olinrobotics/FLA/Prop guard assy.pdf

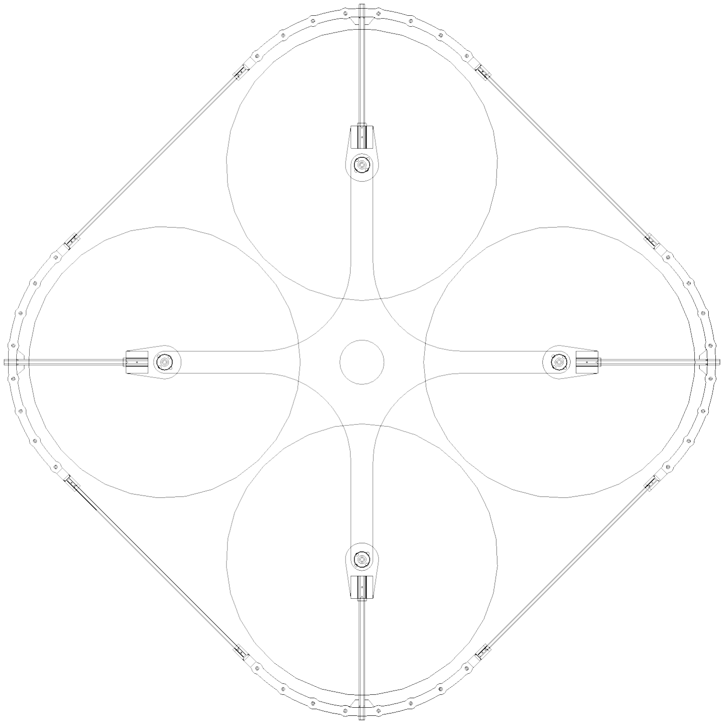
[picture p1: figure]

# Prop

# Guard

# Cage

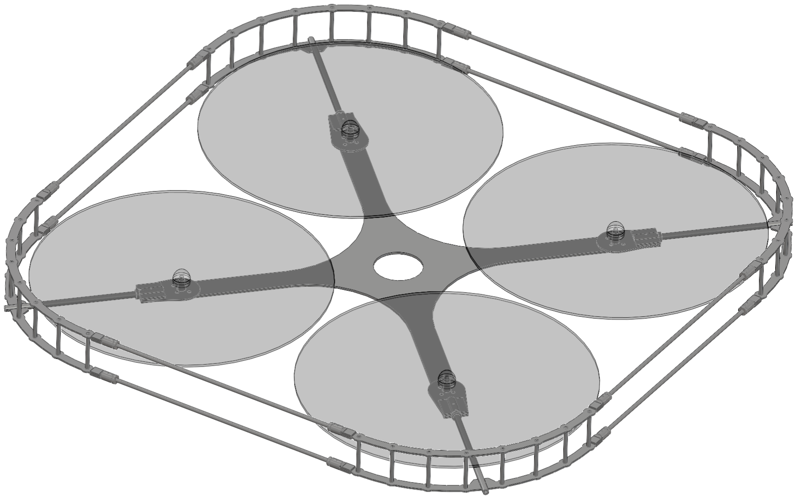
[picture p2: figure]

# Fabrication

Note,

### carbon

### dust

is

### very

### harmful

if

inhaled,

### use

a

### dust

### removal

### system

### when

cu>ng,

sanding,

or

### grinding

### carbon

parts.

### Also

### fumes

### from

CA

### and

### epoxies

### are

harmful,

so

### also

### use

a

### ventilation

### system

### with

### those

adhesives.

### For

### the

epoxy,

### slow

### cure

is

stronger,

5

### minute

### cure

is

okay.

### DP460NS

is

a

### high performance

### epoxy

### that

### would

be

ideal.

### For

### the

CA

### glues

### Bob

### Smith

### brand

### thin

### and

### medium

### viscosity

### glues

### are

good.

### Regular type

is

best,

### but

### foam

### safe

is

okay.

### Also

### the

### foam

### safe

### 'Insta

### Set

### Accelerator'

is

### good for

### kicking

### off

### the

glue,

### particularly

### when

### the

### kevlar

### thread

is

### coated

### with

CA

glue.

### Prepared

by

AV

Inc.

6/2016

### DARPA

### FLA

### Program

1

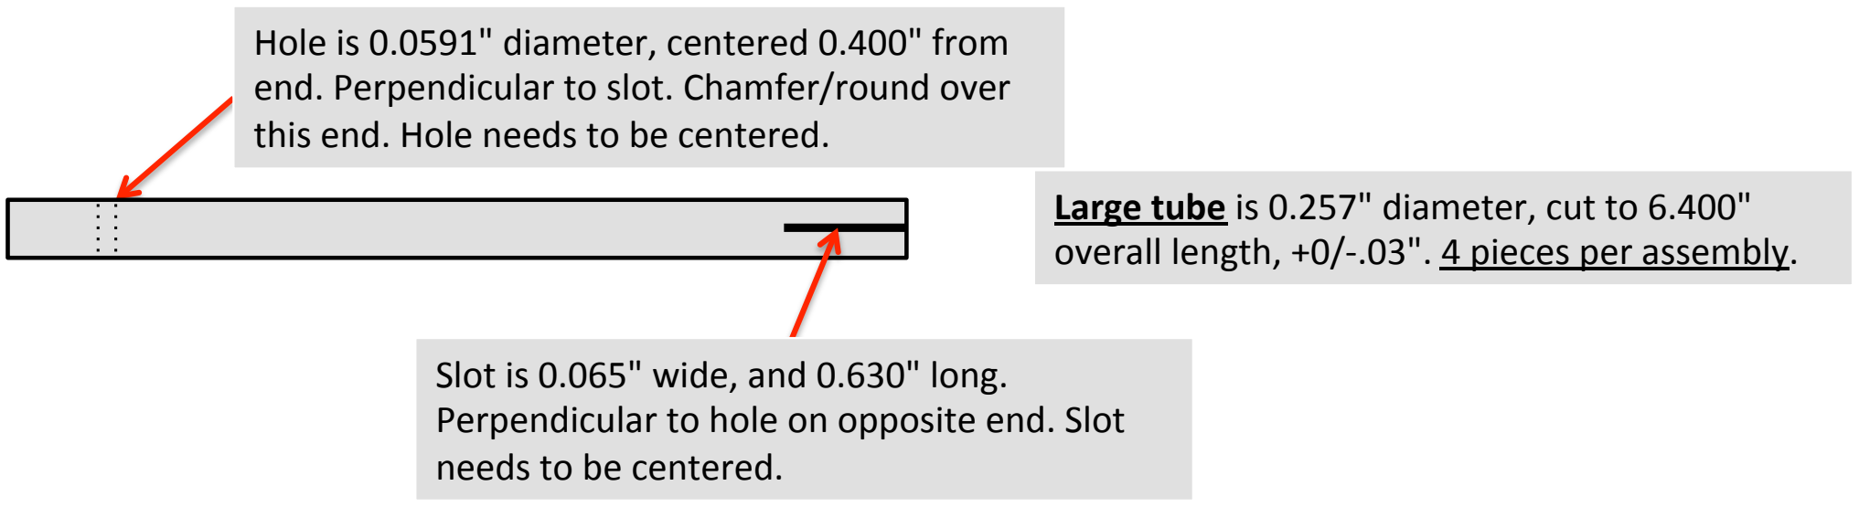
[picture p3: figure]
Large; tube; diameter,; cut; overall; length,; pieces; per; assembly.; Hole; centered; from; end.; Perpendicular; slot.; Chamfer/round; over; this; needs; centered.; Slot; wide,; and; long.; hole; opposite

Small

Short

tube

is

0.155"

diameter,

cut

to
1.930"

overall

length,

+/.02"

32

pieces

per
assembly.

Chamfer/round

over

the

edges.

### Carbon

### tube

### prep

2

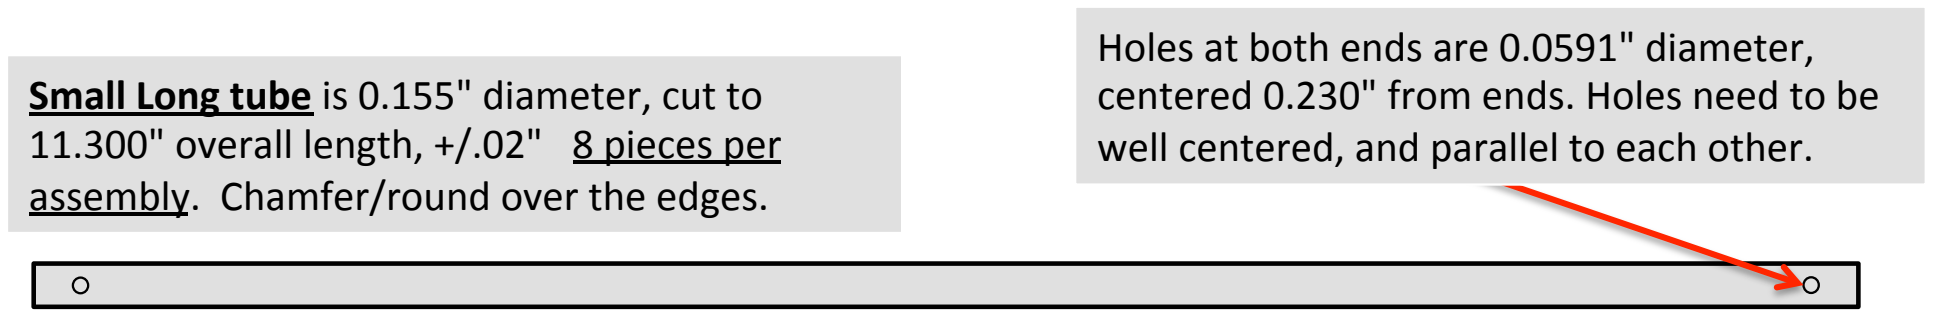
[picture p4: figure]
Small; Long; tube; diameter,; cut; overall; length,; pieces; per; assembly.; Chamfer/round; over; the; edges.; Holes; both; ends; are; centered; from; ends.; need; well; centered,; and; parallel; each; other.

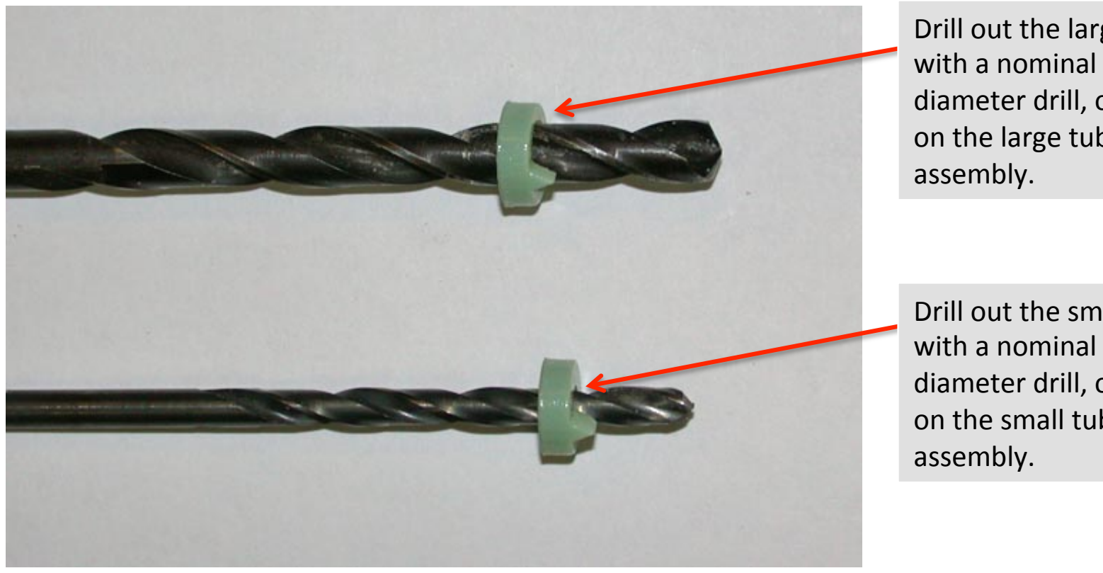
[picture p5: figure]
Drill; out; the; with; nominal diameter; drill,; large assembly.; small assembly.

large

hole

collars
.257"
or

to

fit

snug
tubes.

4

per

small

hole

collars
.156"
or

to

fit

snug
tubes.

16

per

### Collar

### prep

3

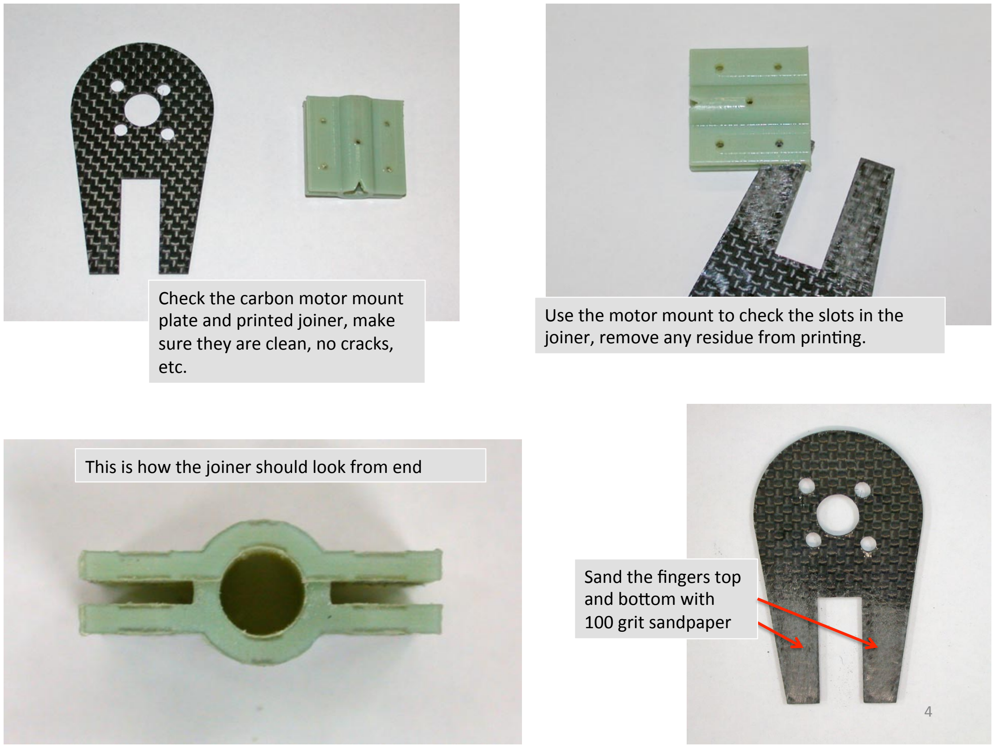
[picture p6: page 4]

Check

the

carbon

motor

mount
plate

and

printed

joiner,

make
sure

they

are

clean,

no

cracks,
etc.

Use

the

motor

mount

to

check

the

slots

in

the
joiner,

remove

any

residue

from

printing.

This

is

how

the

joiner

should

look

from

end

Sand

the

fingers

top
and

bo_om

with
100

grit

sandpaper

4

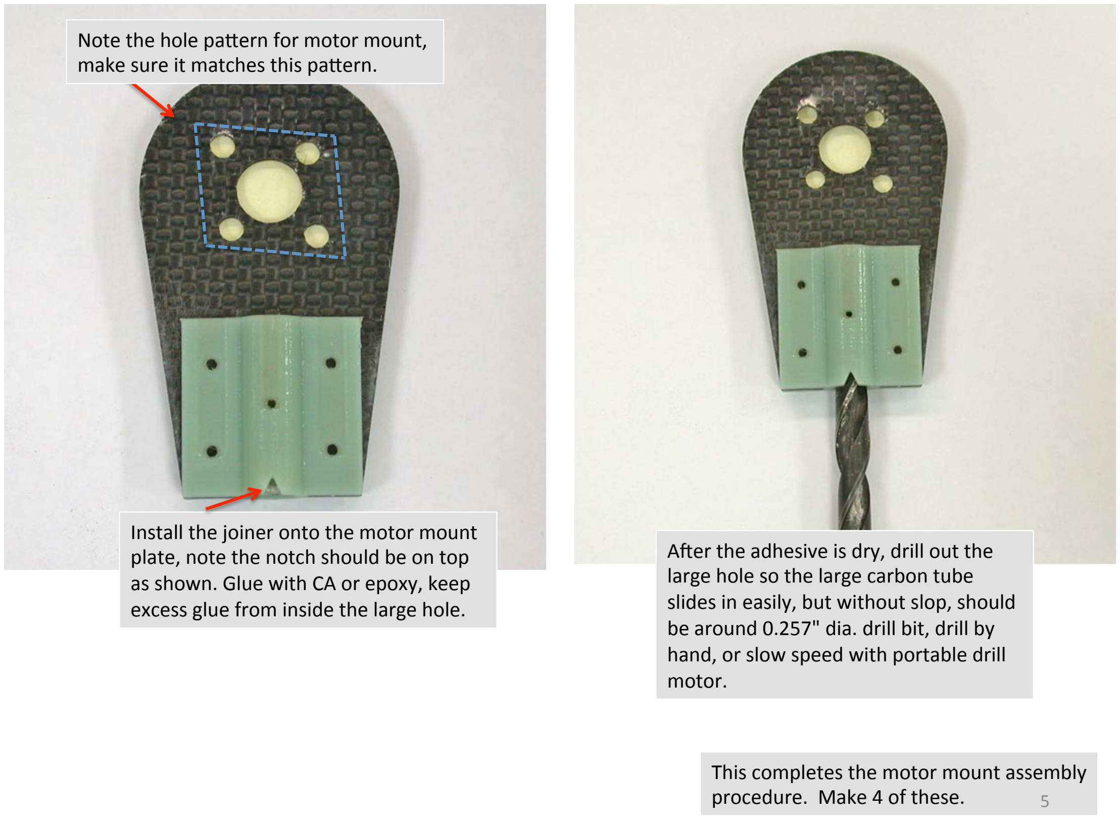
[picture p7: page 5]

Note

the

hole

pa_ern

for

motor

mount,
make

sure

it

matches

this

pa_ern.

Install

the

joiner

onto

the

motor

mount
plate,

note

the

notch

should

be

on

top
as

shown.

Glue

with

CA

or

epoxy,

keep
excess

glue

from

inside

the

large

hole.

A`er

the

adhesive

is

dry,

drill

out

the
large

hole

so

the

large

carbon

tube
slides

in

easily,

but

without

slop,

should
be

around

0.257"

dia.

drill

bit,

drill

by
hand,

or

slow

speed

with

portable

drill
motor.

This

completes

the

motor

mount

assembly
procedure.

Make

4

of

these.
5

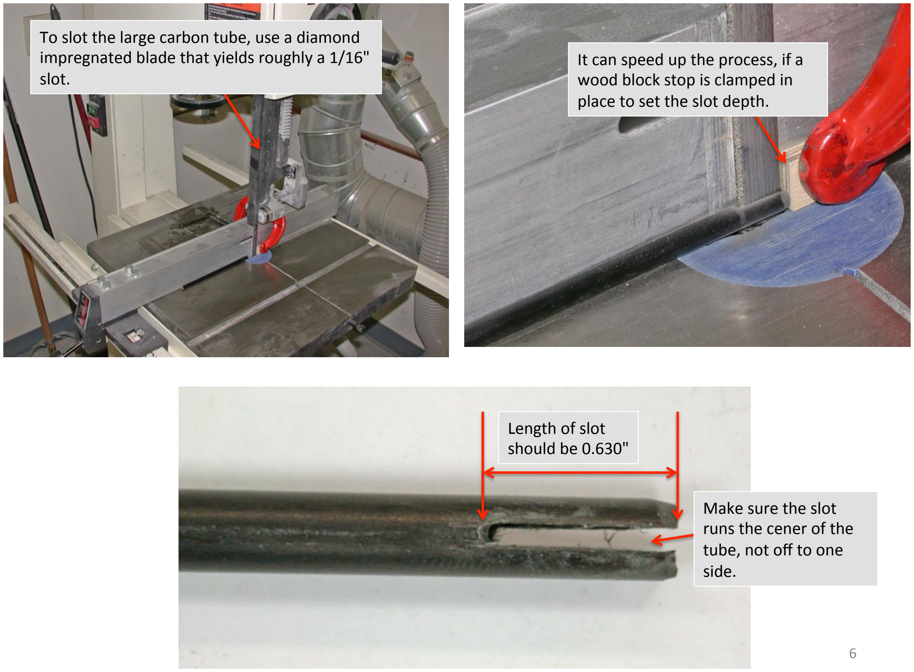
[picture p8: page 6]

To

slot

the

large

carbon

tube,

use

a

diamond
impregnated

blade

that

yields

roughly

a

1/16"
slot.

It

can

speed

up

the

process,

if

a
wood

block

stop

is

clamped

in
place

to

set

the

slot

depth.

Make

sure

the

slot
runs

the

cener

of

the
tube,

not

off

to

one
side.

Length

of

slot
should

be

0.630"

6

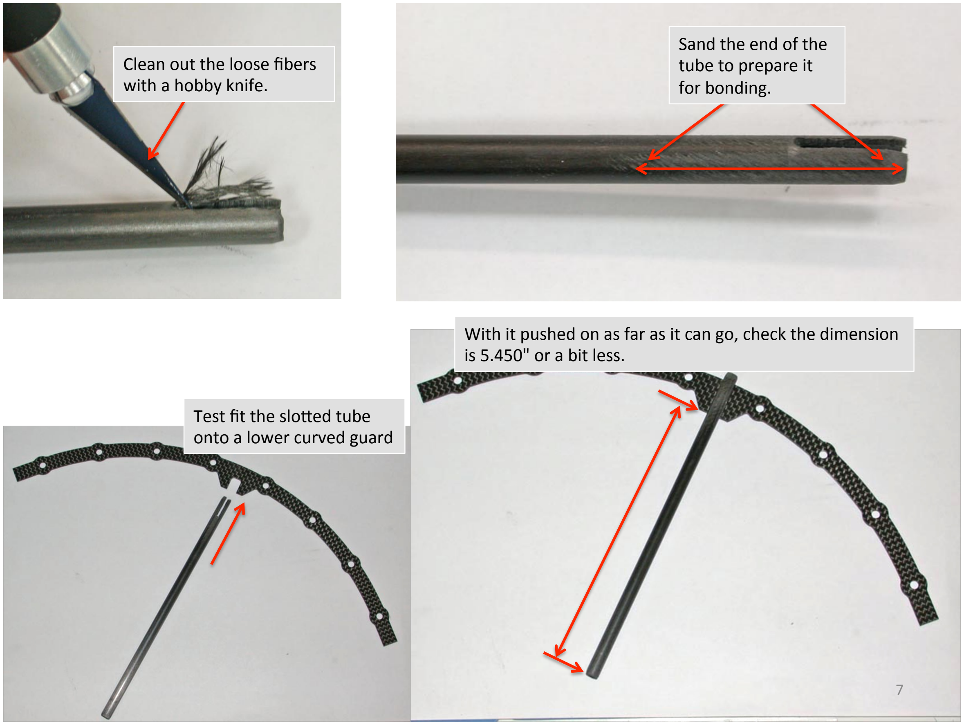
[picture p9: page 7]

Clean

out

the

loose

fibers
with

a

hobby

knife.

Sand

the

end

of

the
tube

to

prepare

it
for

bonding.

Test

fit

the

slo_ed

tube
onto

a

lower

curved

guard

With

it

pushed

on

as

far

as

it

can

go,

check

the

dimension
is

5.450"

or

a

bit

less.

7

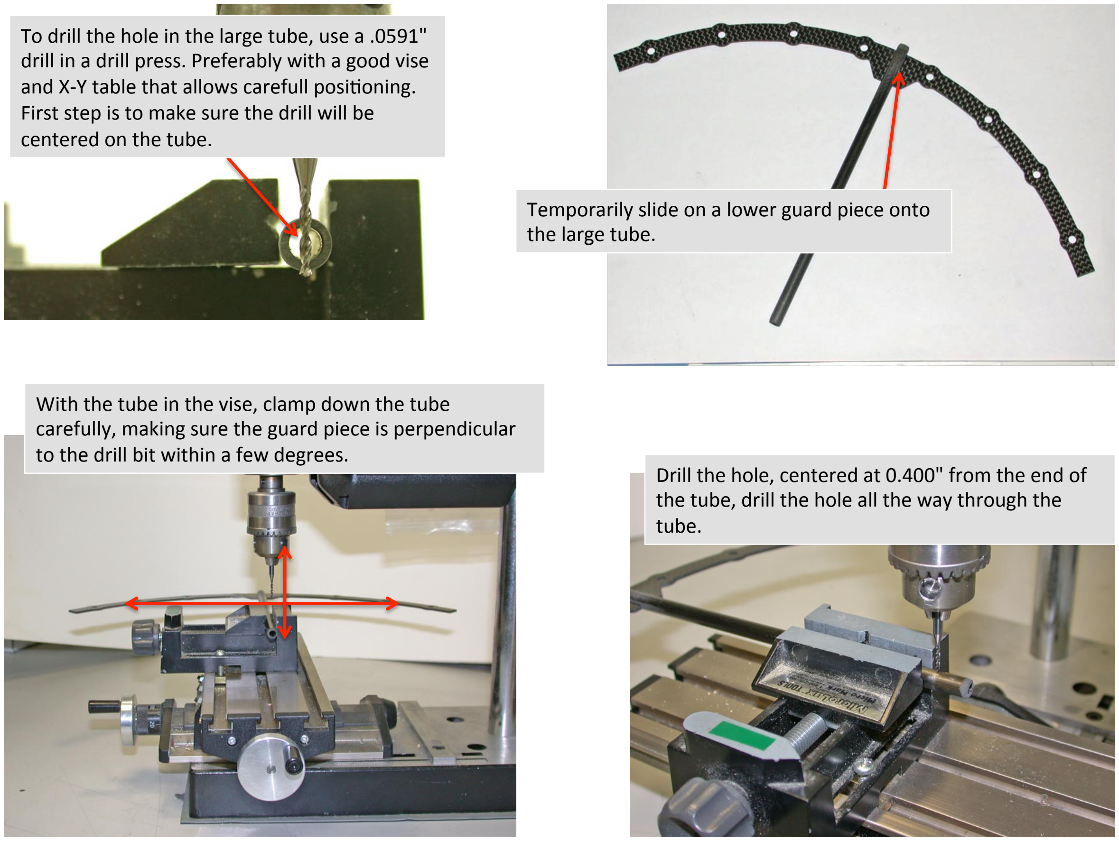
[picture p10: page 8]

To

drill

the

hole

in

the

large

tube,

use

a

.0591"
drill

in

a

drill

press.

Preferably

with

a

good

vise
and

X-‐Y

table

that

allows

carefull

positioning.
First

step

is

to

make

sure

the

drill

will

be
centered

on

the

tube.

Temporarily

slide

on

a

lower

guard

piece

onto
the

large

tube.

With

the

tube

in

the

vise,

clamp

down

the

tube
carefully,

making

sure

the

guard

piece

is

perpendicular
to

the

drill

bit

within

a

few

degrees.
Drill

the

hole,

centered

at

0.400"

from

the

end

of
the

tube,

drill

the

hole

all

the

way

through

the
tube.

8

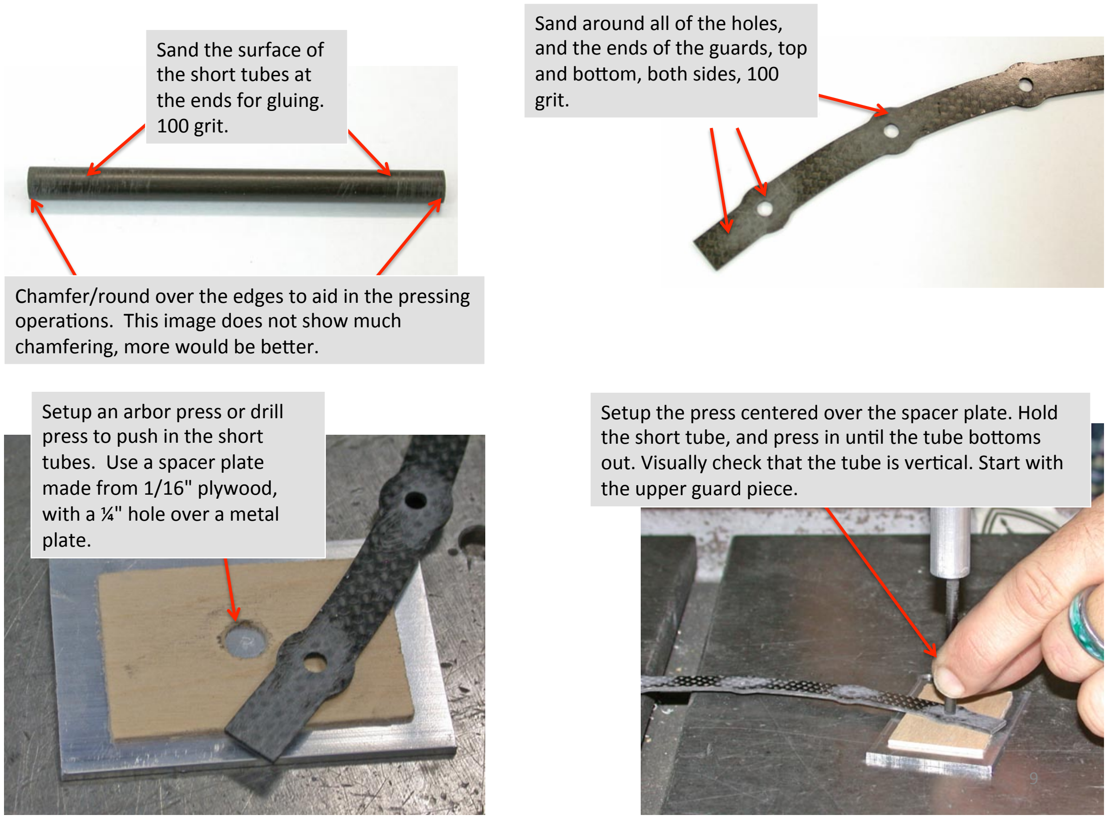
[picture p11: page 9]

Sand

the

surface

of
the

short

tubes

at
the

ends

for

gluing.
100

grit.

Chamfer/round

over

the

edges

to

aid

in

the

pressing
operations.

This

image

does

not

show

much
chamfering,

more

would

be

be_er.

Sand

around

all

of

the

holes,
and

the

ends

of

the

guards,

top
and

bo_om,

both

sides,

100
grit.

Setup

an

arbor

press

or

drill
press

to

push

in

the

short
tubes.

Use

a

spacer

plate
made

from

1/16"

plywood,
with

a

¼"

hole

over

a

metal
plate.

Setup

the

press

centered

over

the

spacer

plate.

Hold
the

short

tube,

and

press

in

until

the

tube

bo_oms
out.

Visually

check

that

the

tube

is

vertical.

Start

with
the

upper

guard

piece.

9

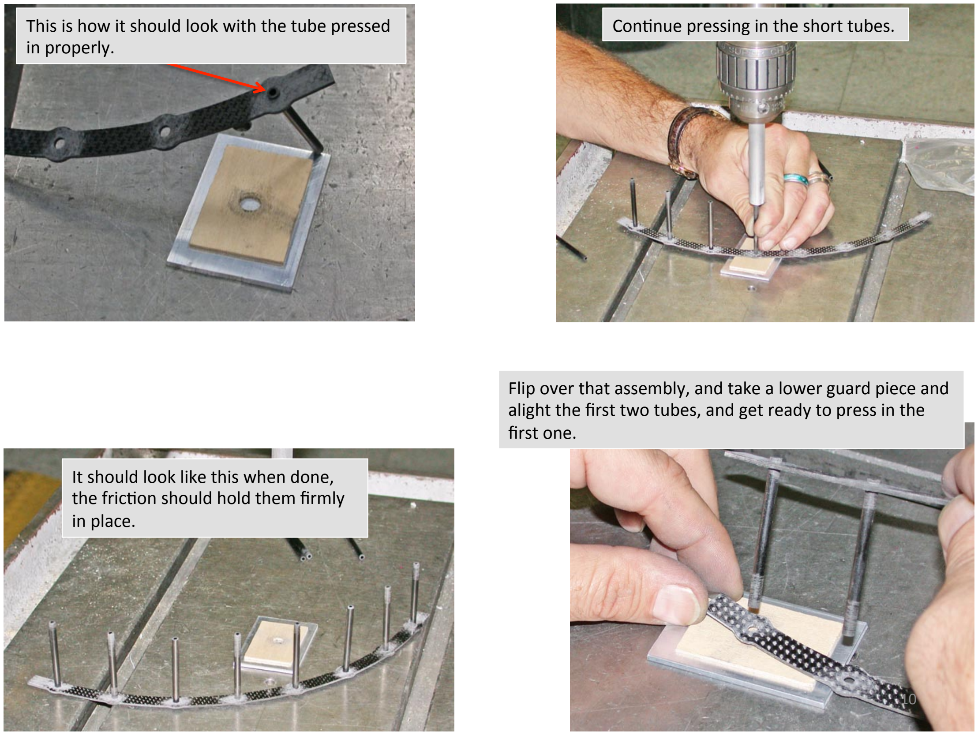
[picture p12: page 10]

This

is

how

it

should

look

with

the

tube

pressed
in

properly.

Continue

pressing

in

the

short

tubes.

It

should

look

like

this

when

done,
the

friction

should

hold

them

firmly
in

place.

Flip

over

that

assembly,

and

take

a

lower

guard

piece

and
alight

the

first

two

tubes,

and

get

ready

to

press

in

the
first

one.

10

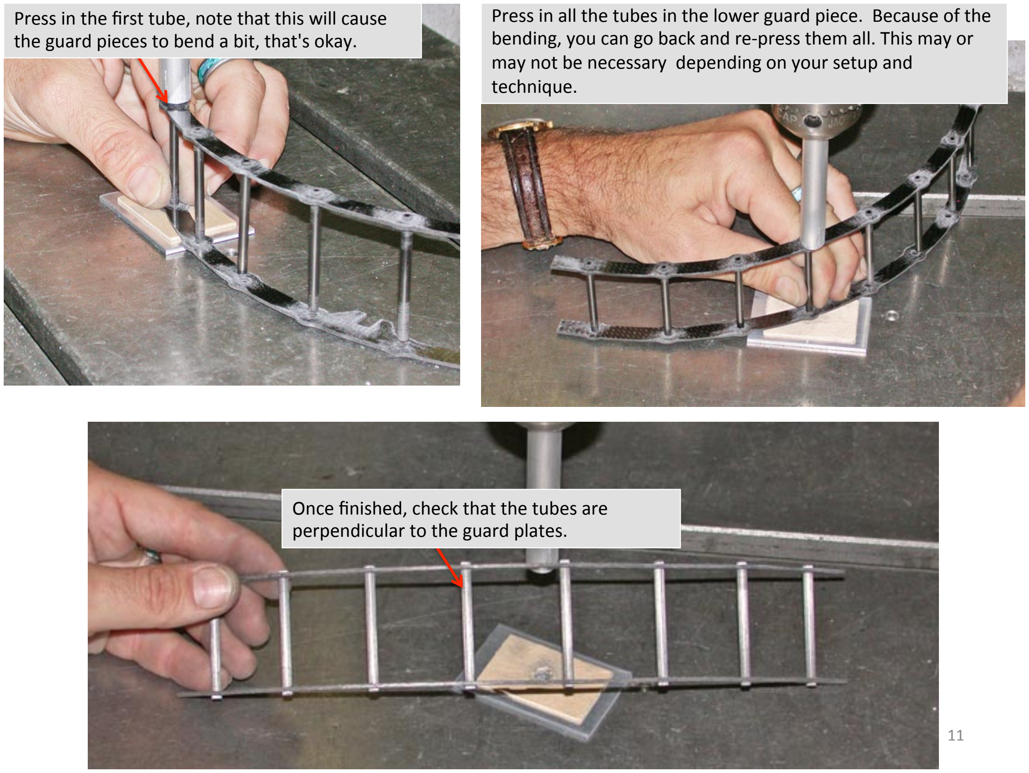
[picture p13: page 11]

Press

in

the

first

tube,

note

that

this

will

cause
the

guard

pieces

to

bend

a

bit,

that's

okay.

Press

in

all

the

tubes

in

the

lower

guard

piece.

Because

of

the
bending,

you

can

go

back

and

re-‐press

them

all.

This

may

or
may

not

be

necessary

depending

on

your

setup

and
technique.

Once

finished,

check

that

the

tubes

are
perpendicular

to

the

guard

plates.

11

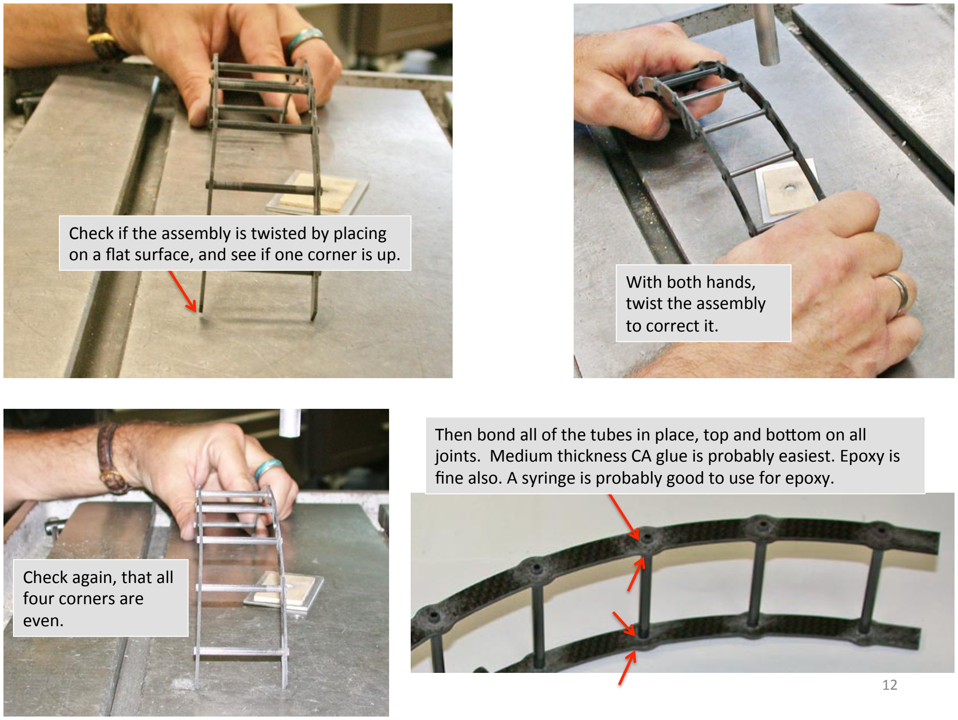
[picture p14: page 12]

Check

if

the

assembly

is

twisted

by

placing
on

a

flat

surface,

and

see

if

one

corner

is

up.
With

both

hands,
twist

the

assembly
to

correct

it.

Check

again,

that

all
four

corners

are
even.

Then

bond

all

of

the

tubes

in

place,

top

and

bo_om

on

all
joints.

Medium

thickness

CA

glue

is

probably

easiest.

Epoxy

is
fine

also.

A

syringe

is

probably

good

to

use

for

epoxy.

12

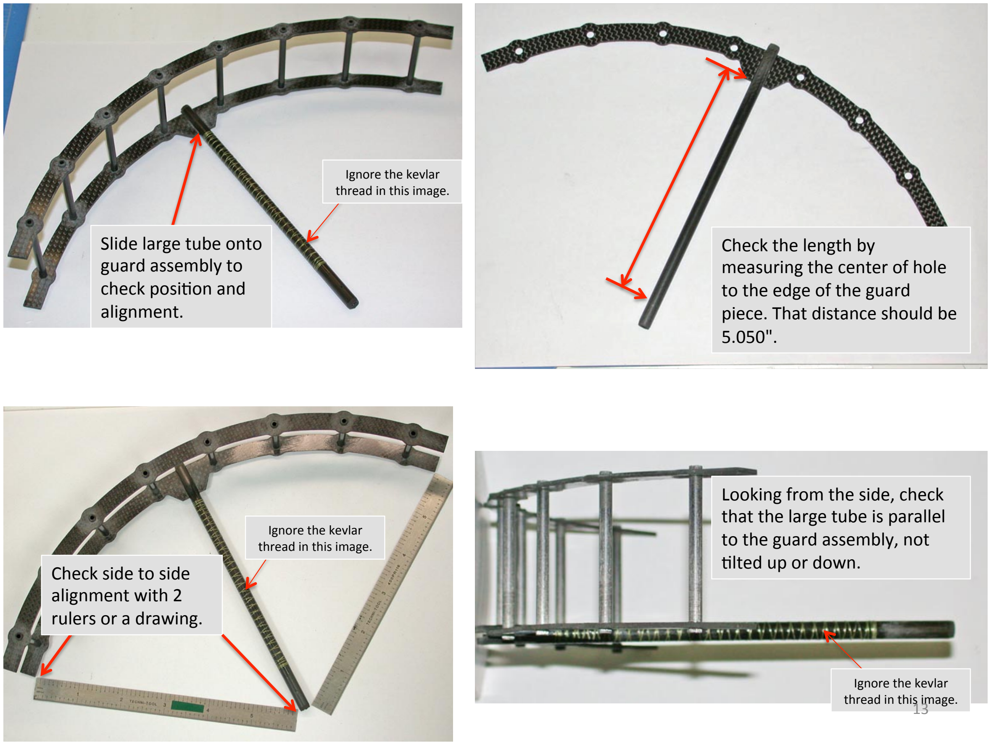
[picture p15: page 13]

Ignore

the

kevlar
thread

in

this

image.

Ignore

the

kevlar
thread

in

this

image.

Ignore

the

kevlar
thread

in

this

image.

Slide

large

tube

onto
guard

assembly

to
check

position

and
alignment.

Check

side

to

side
alignment

with

2
rulers

or

a

drawing.

Check

the

length

by
measuring

the

center

of

hole
to

the

edge

of

the

guard
piece.

That

distance

should

be
5.050".

Looking

from

the

side,

check
that

the

large

tube

is

parallel
to

the

guard

assembly,

not
1lted

up

or

down.

13

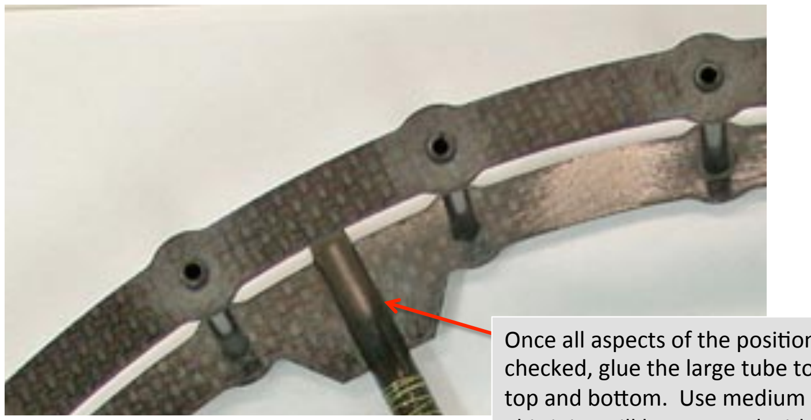
[picture p16: figure]
Once; all; aspects; the; checked,; glue; large; tube; top; and; Use; medium

position

and

alignment

are
to

the

guard

assembly,
CA

glue

or

epoxy.
This

joint

will

be

wrapped

with

Kevlar

thread

a`er
this

step,

so

you

don't

need

to

use

a

lot

of

glue

on
this

step.

14

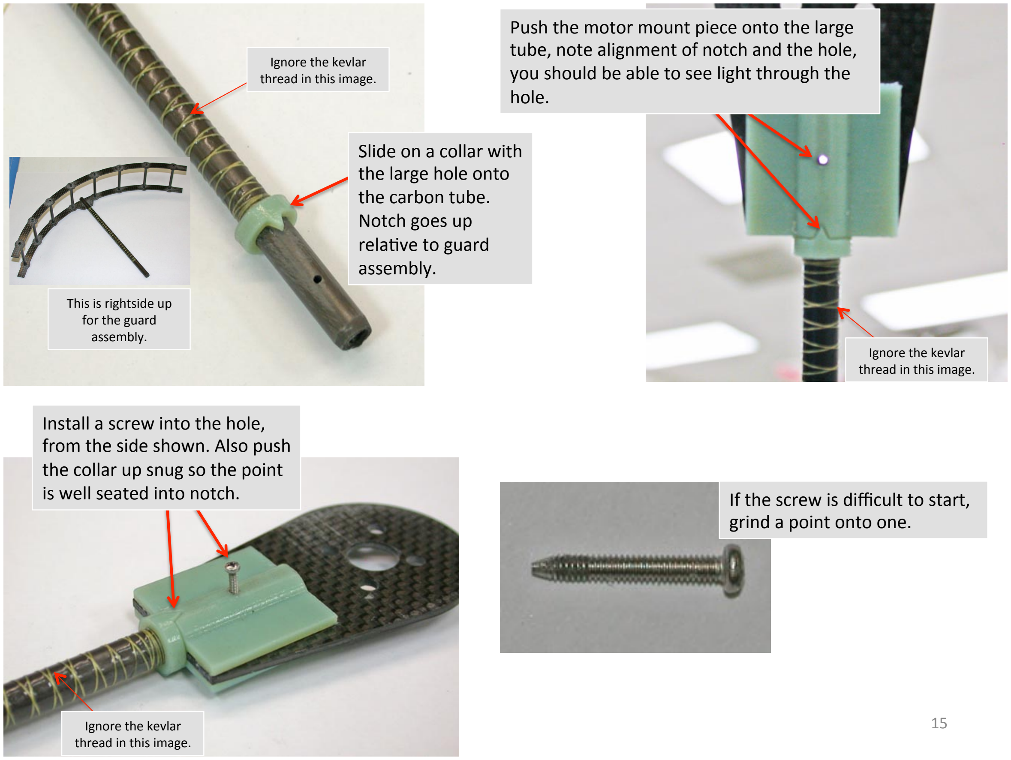
[picture p17: page 15]

Ignore

the

kevlar
thread

in

this

image.

Ignore

the

kevlar
thread

in

this

image.

Ignore

the

kevlar
thread

in

this

image.

Slide

on

a

collar

with
the

large

hole

onto
the

carbon

tube.
Notch

goes

up
relative

to

guard
assembly.

This

is

rightside

up
for

the

guard
assembly.

Push

the

motor

mount

piece

onto

the

large
tube,

note

alignment

of

notch

and

the

hole,
you

should

be

able

to

see

light

through

the
hole.

Install

a

screw

into

the

hole,
from

the

side

shown.

Also

push
the

collar

up

snug

so

the

point
is

well

seated

into

notch.
If

the

screw

is

difficult

to

start,
grind

a

point

onto

one.

15

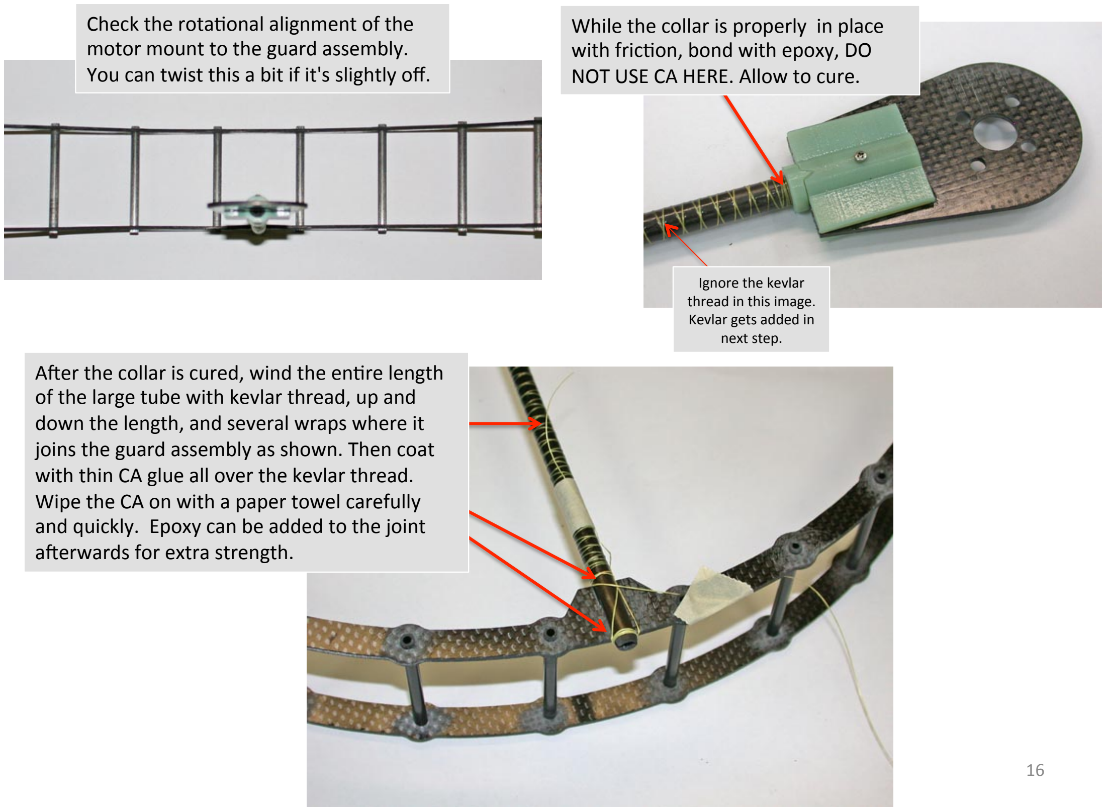
[picture p18: page 16]

Ignore

the

kevlar
thread

in

this

image.
Kevlar

gets

added

in
next

step.

While

the

collar

is

properly

in

place
with

friction,

bond

with

epoxy,

DO
NOT

USE

CA

HERE.

Allow

to

cure.

Check

the

rotational

alignment

of

the
motor

mount

to

the

guard

assembly.
You

can

twist

this

a

bit

if

it's

slightly

off.

A`er

the

collar

is

cured,

wind

the

entire

length
of

the

large

tube

with

kevlar

thread,

up

and
down

the

length,

and

several

wraps

where

it
joins

the

guard

assembly

as

shown.

Then

coat
with

thin

CA

glue

all

over

the

kevlar

thread.
Wipe

the

CA

on

with

a

paper

towel

carefully
and

quickly.

Epoxy

can

be

added

to

the

joint
a`erwards

for

extra

strength.

16

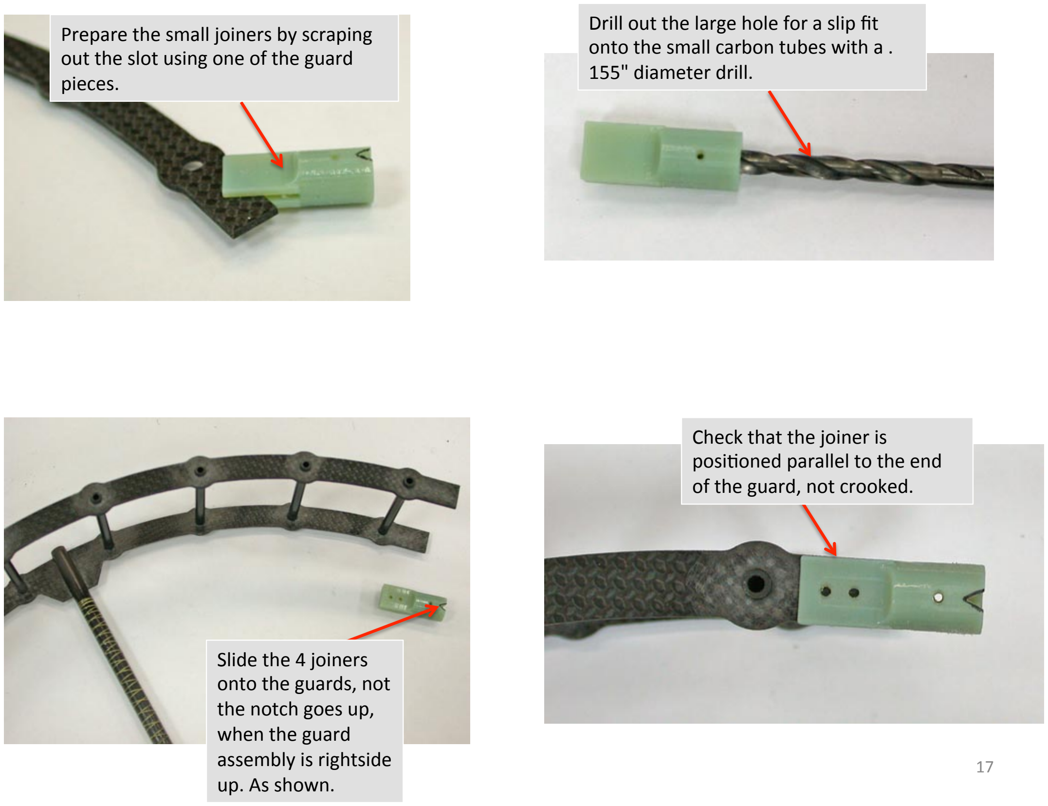
[picture p19: page 17]

Prepare

the

small

joiners

by

scraping
out

the

slot

using

one

of

the

guard
pieces.

Drill

out

the

large

hole

for

a

slip

fit
onto

the

small

carbon

tubes

with

a

155"

diameter

drill.

Slide

the

4

joiners
onto

the

guards,

not
the

notch

goes

up,
when

the

guard
assembly

is

rightside
up.

As

shown.

Check

that

the

joiner

is
positioned

parallel

to

the

end
of

the

guard,

not

crooked.

17

Check

that

the

joiner

is
completely

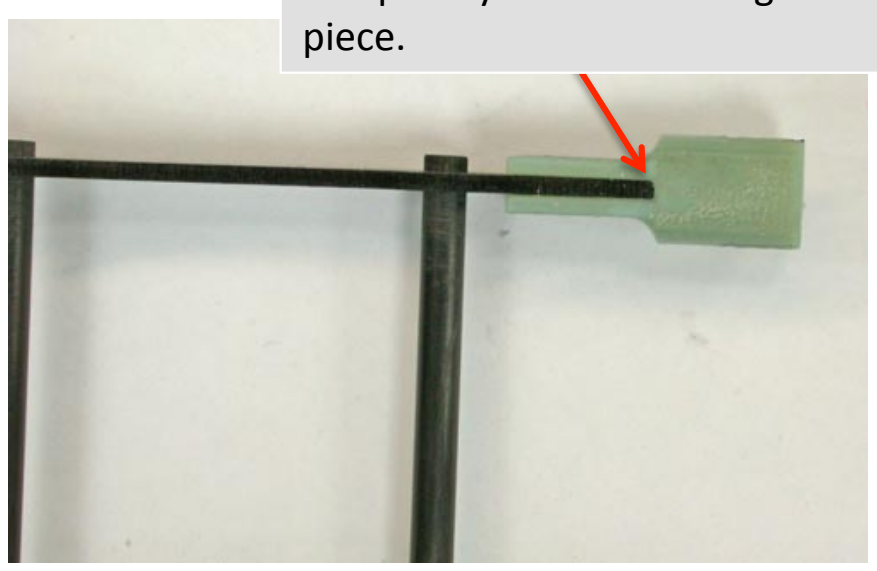
[picture p20: figure]
piece.

seated

on

the

guard

Glue

the

joiner

onto

the

guard

with

CA

glue

or
epoxy,

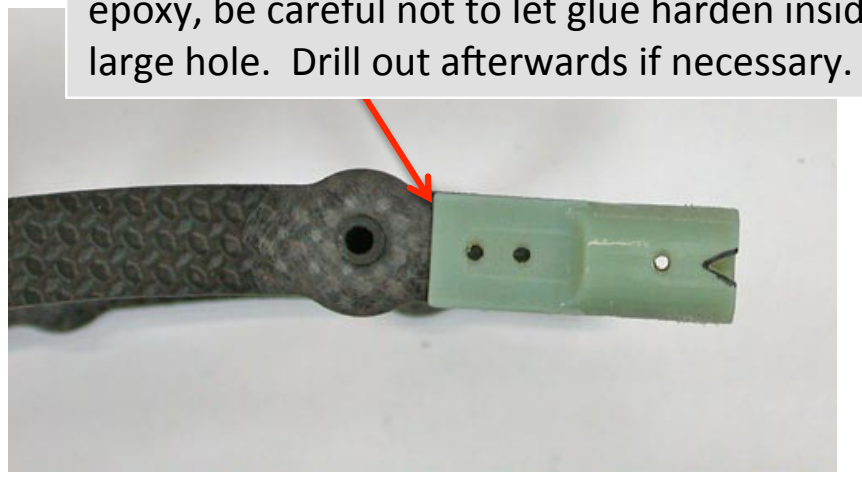
[picture p21: figure]
large; hole.; Drill; out; a`erwards; necessary.

be

careful

not

to

let

glue

harden

inside

the

A`er

installing

all

4

joiners

onto

the

guard
assembly,

this

completes

the

guard
assembly

procedure.

Make

4

of

these.

18

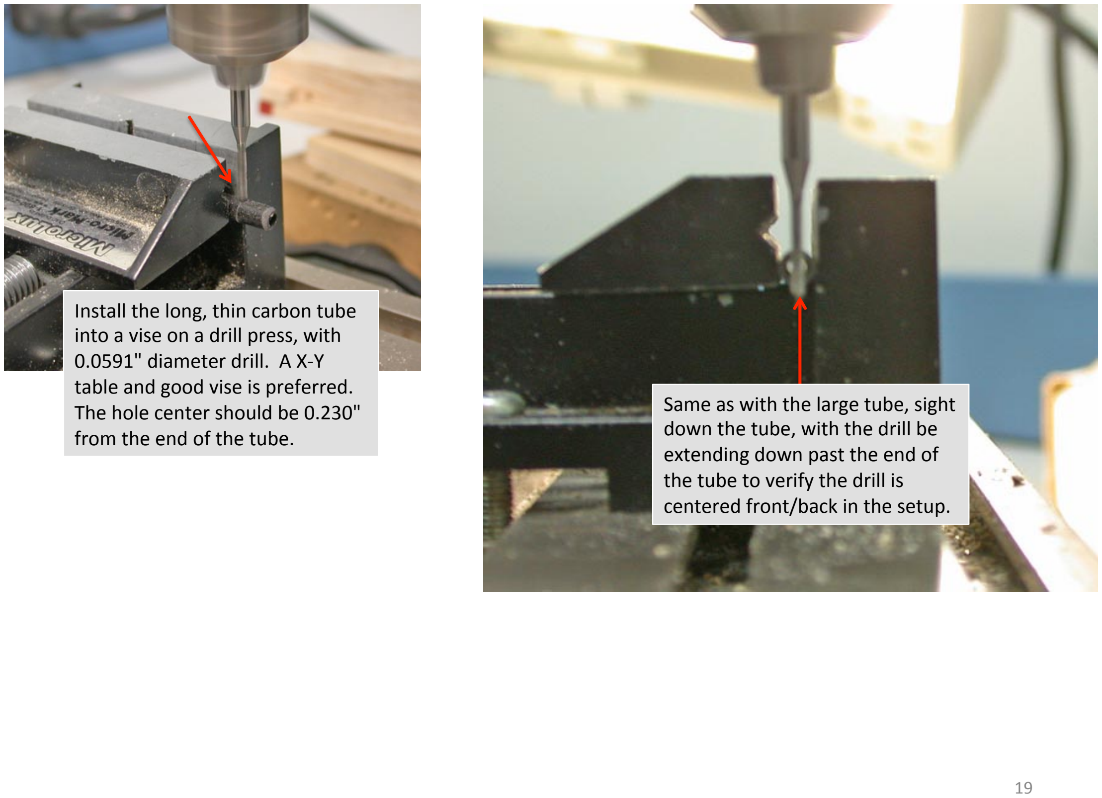
[picture p22: page 19]

Install

the

long,

thin

carbon

tube
into

a

vise

on

a

drill

press,

with
0.0591"

diameter

drill.

A

X-‐Y
table

and

good

vise

is

preferred.
The

hole

center

should

be

0.230"
from

the

end

of

the

tube.

Same

as

with

the

large

tube,

sight
down

the

tube,

with

the

drill

be
extending

down

past

the

end

of
the

tube

to

verify

the

drill

is
centered

front/back

in

the

setup.

19

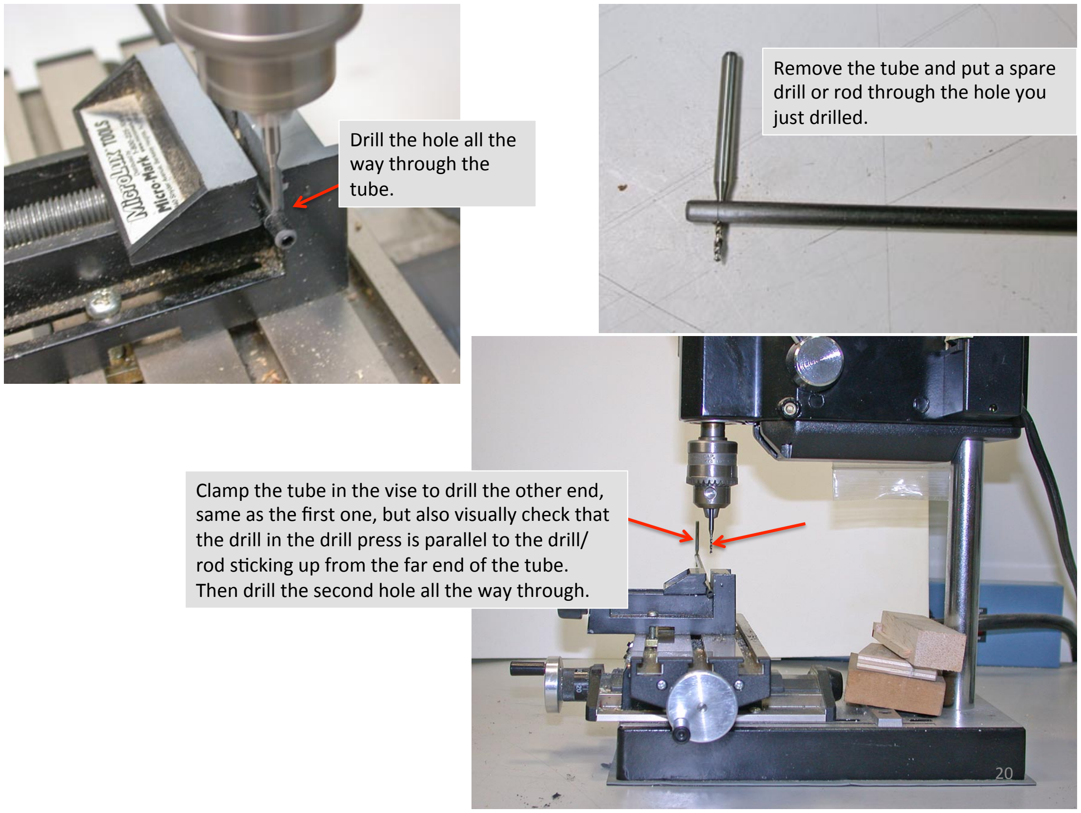
[picture p23: page 20]

Drill

the

hole

all

the
way

through

the
tube.

Remove

the

tube

and

put

a

spare
drill

or

rod

through

the

hole

you
just

drilled.

Clamp

the

tube

in

the

vise

to

drill

the

other

end,
same

as

the

first

one,

but

also

visually

check

that
the

drill

in

the

drill

press

is

parallel

to

the

drill/
rod

sticking

up

from

the

far

end

of

the

tube.
Then

drill

the

second

hole

all

the

way

through.

20

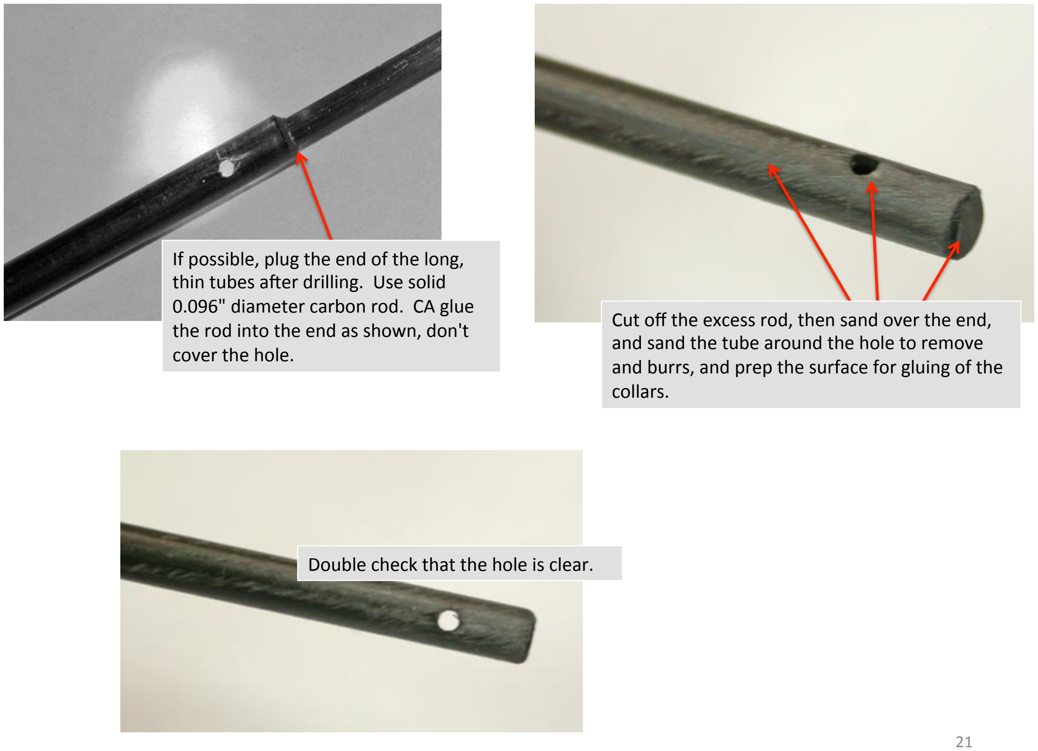
[picture p24: page 21]

If

possible,

plug

the

end

of

the

long,
thin

tubes

a`er

drilling.

Use

solid
0.096"

diameter

carbon

rod.

CA

glue
the

rod

into

the

end

as

shown,

don't
cover

the

hole.

Cut

off

the

excess

rod,

then

sand

over

the

end,
and

sand

the

tube

around

the

hole

to

remove
and

burrs,

and

prep

the

surface

for

gluing

of

the
collars.

Double

check

that

the

hole

is

clear.

21

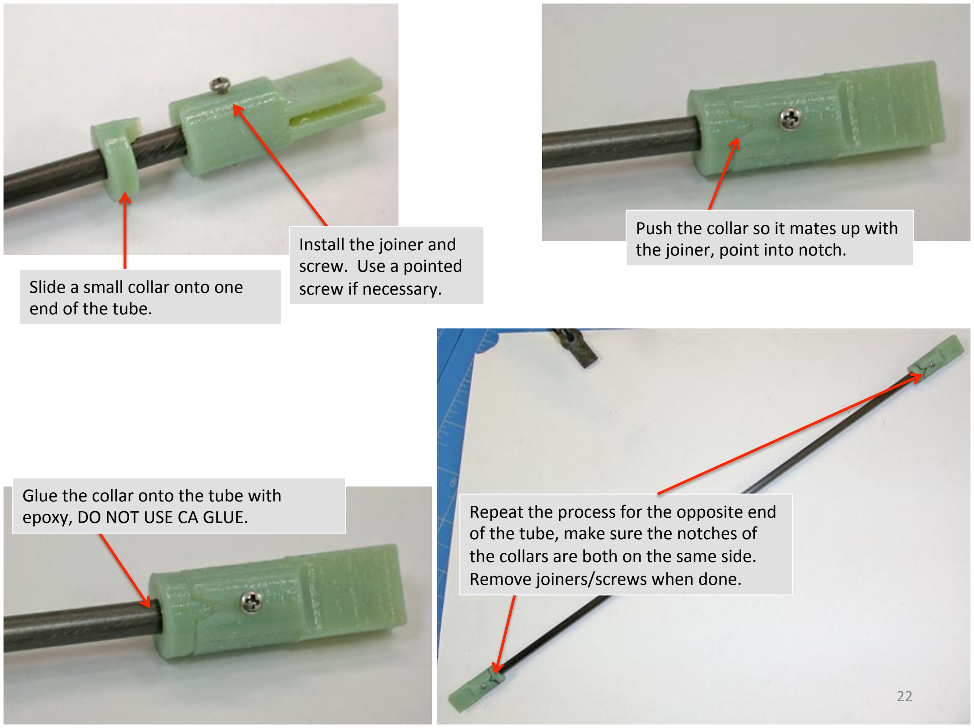
[picture p25: page 22]

Slide

a

small

collar

onto

one
end

of

the

tube.

Install

the

joiner

and
screw.

Use

a

pointed
screw

if

necessary.

Push

the

collar

so

it

mates

up

with
the

joiner,

point

into

notch.

Glue

the

collar

onto

the

tube

with
epoxy,

DO

NOT

USE

CA

GLUE.

Repeat

the

process

for

the

opposite

end
of

the

tube,

make

sure

the

notches

of
the

collars

are

both

on

the

same

side.
Remove

joiners/screws

when

done.

22

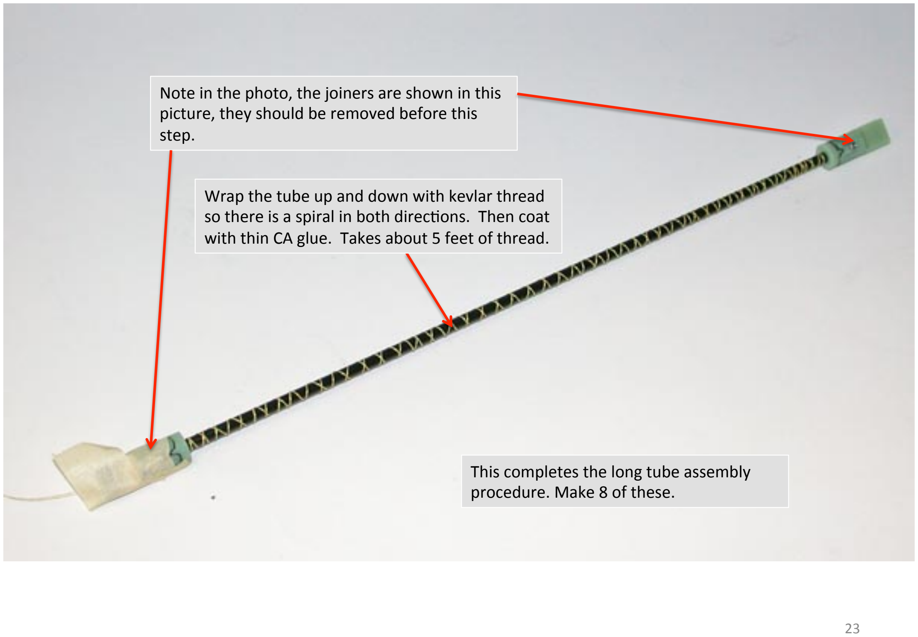
[picture p26: page 23]

Wrap

the

tube

up

and

down

with

kevlar

thread
so

there

is

a

spiral

in

both

directions.

Then

coat
with

thin

CA

glue.

Takes

about

5

feet

of

thread.

Note

in

the

photo,

the

joiners

are

shown

in

this
picture,

they

should

be

removed

before

this
step.

This

completes

the

long

tube

assembly
procedure.

Make

8

of

these.

23

### This

### completes

### the

### steps

to

### build

### all

of

### the

### prop

### guard

sub-‐assemblies.

To

### install

### the

### prop

### guard

### cage

### onto

### the

### aircra`

### for

### the

### first

1me:

### 1. Install

### the

### new

### motor

### mount

### piece

### under

### the

motor,

### note

### notch

### goes

up.

### Use

### long motor

### mounting

screws,

### not

### the

### factory

### supplied

### DJI

ones.

Do

### not

### 1ghten

### down

firmly,

### allow

### the

### motor

### mount

to

### move

a

bit,

### they

### will

be

### 1ghtened

at

### the

end.

### 2. Take

### two

of

### the

### prop

guards,

### and

### install

4

of

### the

### long

### tubes

### into

### each

of

them.

### 3. Slide

### the

### two

### prop

### guards

### with

### the

### long

### tubes

on

### the

### motor

### mounts

on

### opposite

### sides

of

### the

vehicle,

### but

do

### not

### insert

### all

### the

way,

### leave

### about

a

¼"

gap.

### 4. Install

### the

### other

2

### prop

guards,

### again

### leaving

### around

a

¼"

gap.

### 5. Flex

### the

### assembly

as

necessary,

### and

### insert

### the

### long

### tubes

### into

### all

of

### the

### prop

guards,

so

### all

of

### the

### long

### tubes

### are

inserted,

at

### least

a

### li_le

bit.

### 6. Insert

### the

### prop

### guards

### into

### the

### motor

### mounts

further,

### and

### then

### insert

### the

### long

### tubes into

### the

### prop

### guards

a

### bit

further,

### and

### keep

### going

### around

### the

### vehicle

### doing

### this

### until everything

is

### fi_ed

1ghtly.

### 7. Install

### all

of

### the

### small

screws,

### there

### are

20

total.

### 8. Then

### 1ghten

### the

4

### screws

### under

### each

motor.

### 9. This

### completes

### the

### first

### installation

process.
10. To

### remove

### the

### prop

### guard

cage,

do

### the

### same

### process

in

reverse,

### but

### don't

### touch

### the motor

### mounting

screws.

### Just

### remove

### the

20

1ny

screws.

24

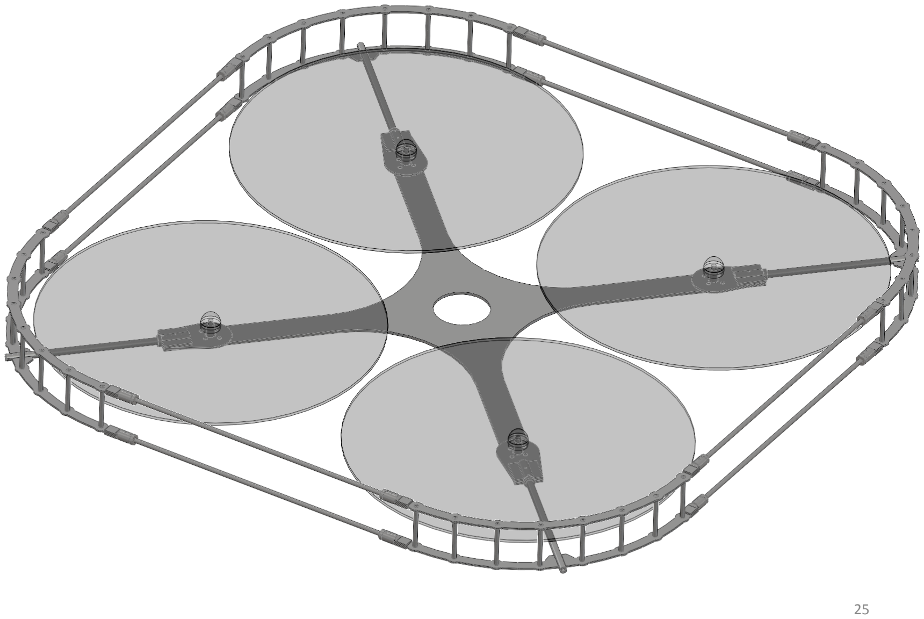
[picture p27: page 25]

25

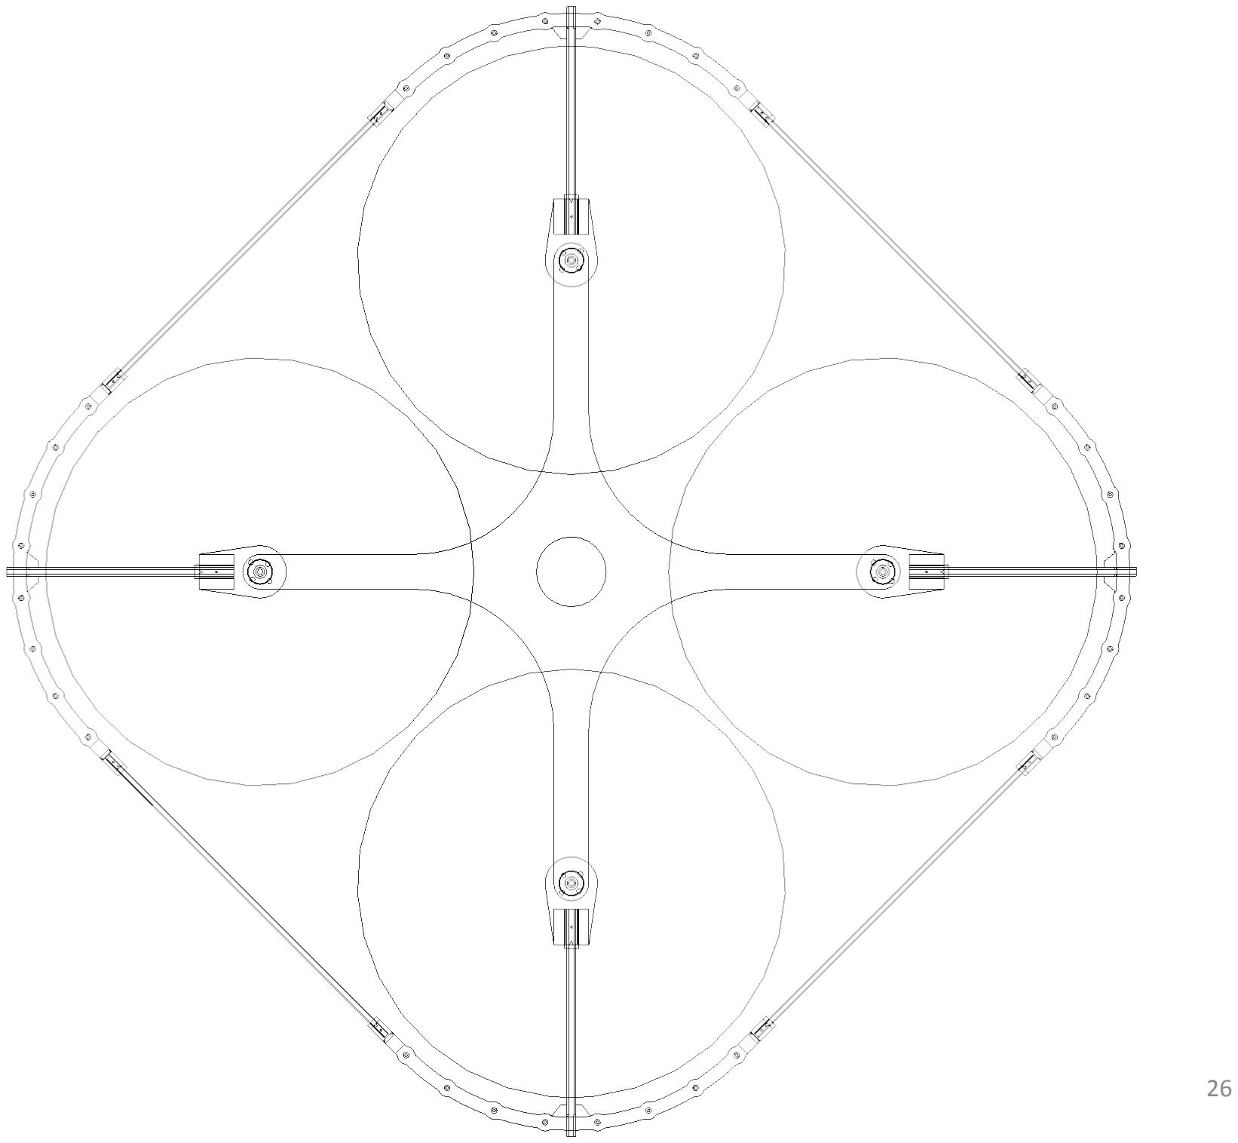
[picture p28: page 26]

26
