olinrobotics/FLA/Box.SLDPRT

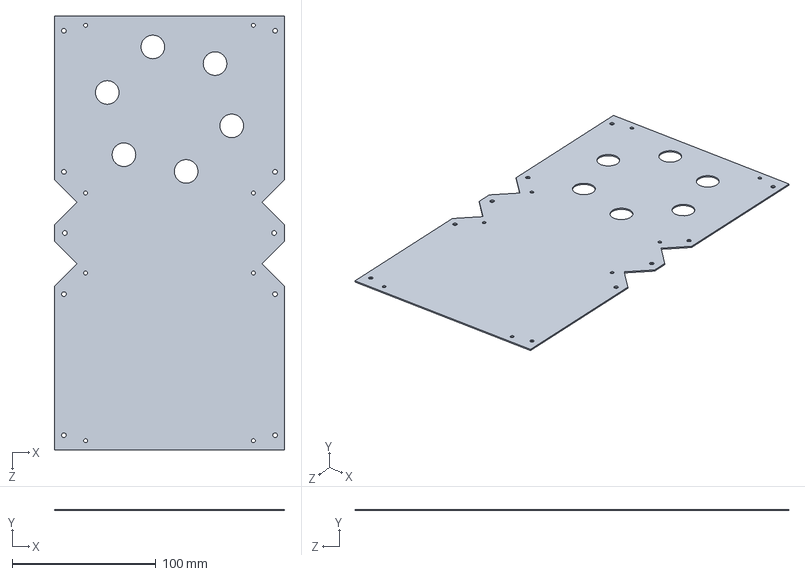
[picture p45: CAD file, 2016-08-04]
Box.SLDPRT
160.3 x 1.02 x 302.1 mm
