olinrobotics/FLA/GPSStand/mountBottom.SLDPRT

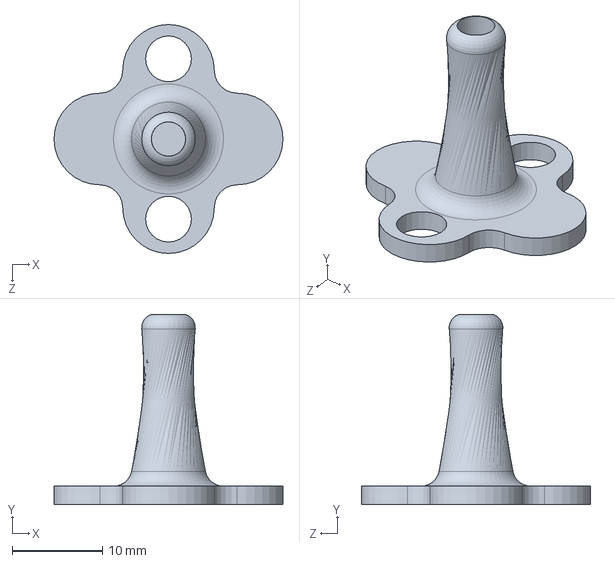
[picture p46: CAD file, 2016-08-04]
GPSStand/mountBottom.SLDPRT
25.4 x 21.1 x 25.4 mm
