olinrobotics/FLA/GPSStand/mountnew.SLDPRT

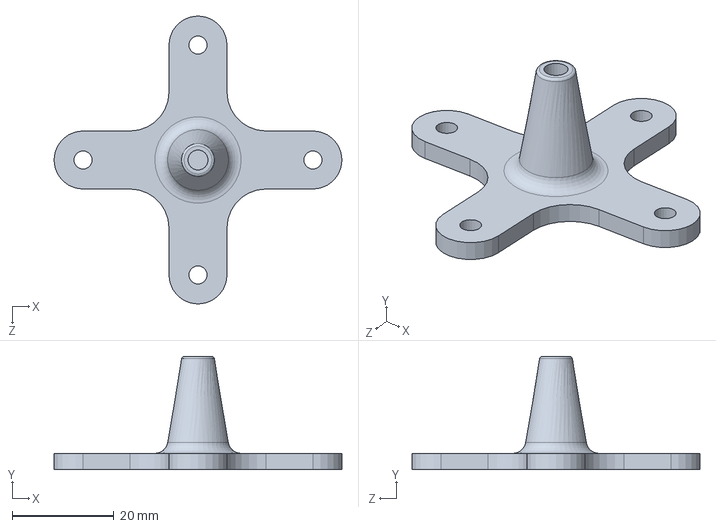
[picture p47: CAD file, 2016-08-04]
GPSStand/mountnew.SLDPRT
56.6 x 22.2 x 56.6 mm
