olinrobotics/FLA/zipTie.SLDPRT

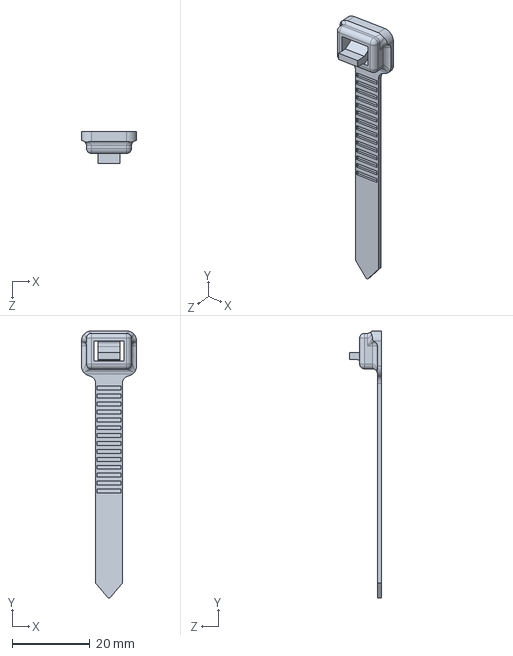
[picture p48: CAD file, 2016-08-04]
zipTie.SLDPRT
14.2 x 68.6 x 8.11 mm
