olinrobotics/FLA/GPSStand/mountTop.SLDPRT

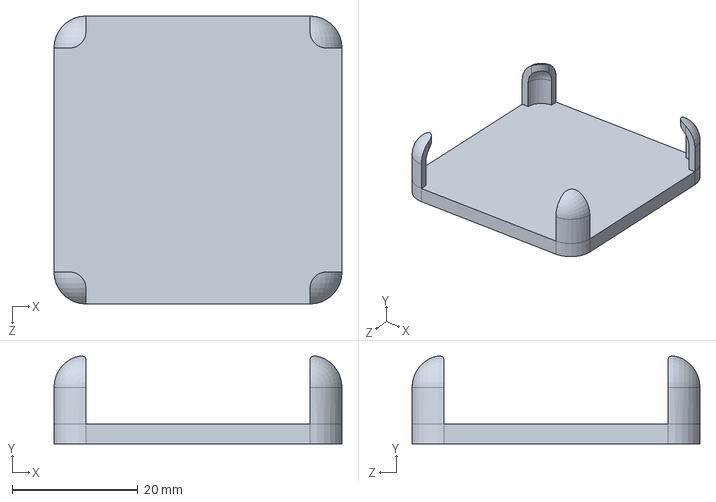
[picture p49: CAD file, 2016-08-04]
GPSStand/mountTop.SLDPRT
45.8 x 14.0 x 45.8 mm
