olinrobotics/FLA/mountProp.SLDPRT

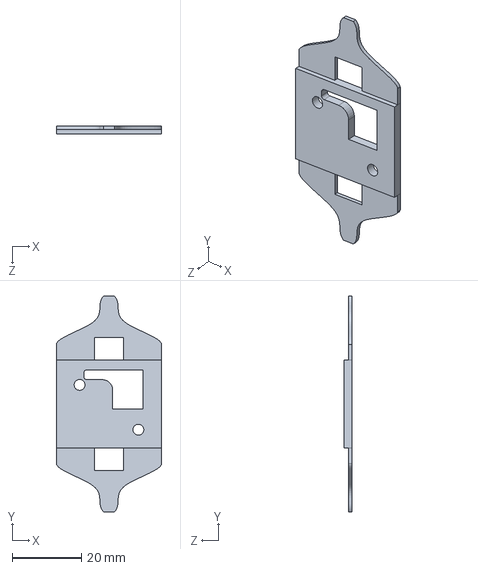
[picture p50: CAD file, 2016-08-04]
mountProp.SLDPRT
30.5 x 62.5 x 2.29 mm
