olinrobotics/FLA/GPSStand/mountside.SLDPRT

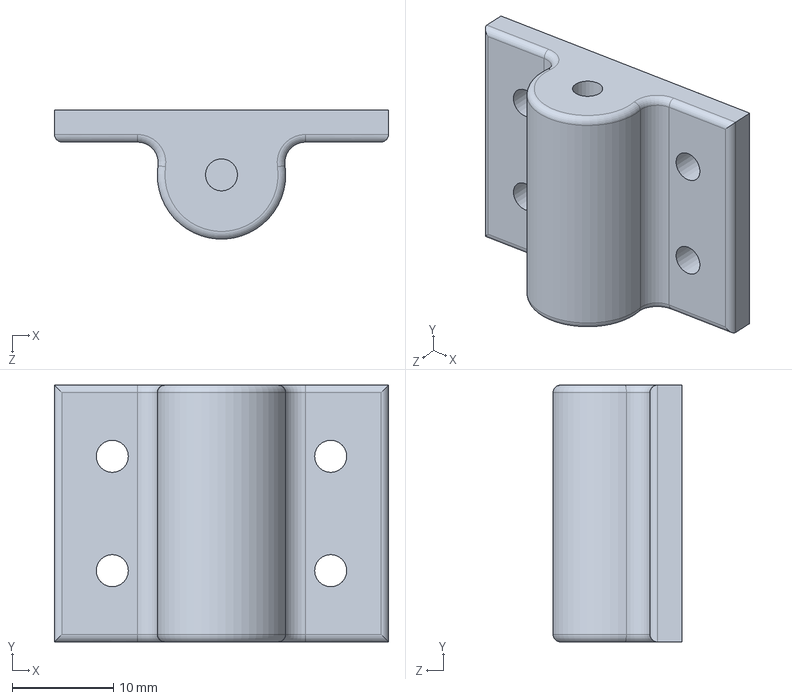
[picture p51: CAD file, 2016-08-04]
GPSStand/mountside.SLDPRT
33.0 x 25.4 x 12.8 mm
