olinrobotics/FLA/(list of files, cad)

Other CAD files:
GPSStand/mountTop2.SLDPRT
