olinrobotics/FLA/3D Printed Adjustable Zip Tie.pdf

### 3D Printed Adjustable Zip Tie

Problem: Mount a sonar sensor on the prop guard.

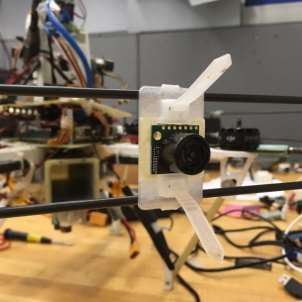
[picture p60: figure]

Solution: A mount plate with two adjustable zip tie

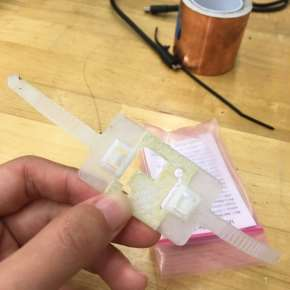
[picture p61: figure]

The zip tie is print with nylon in Markforged.

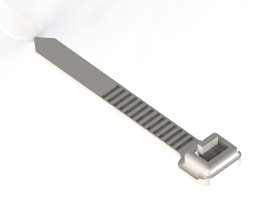
[picture p62: figure]

The extra lip on the zip tie makes it easier to take it off.

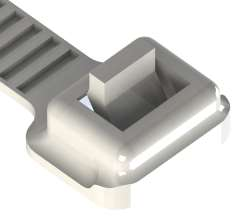
[picture p63: figure]

CAD file: zipTie and mountProp

Any questions or suggestions, email jingyi.xu@students.olin.edu
